XplaneAvgeek/Flight-Computer-V3/Flight_Computer_V2_Proto2/production/FlightComputerV1_Proto1_bom.csv

Designator | Footprint | Quantity | Value | LCSC Part #
C1, C2 | 0805 | 2 | 2.2uF
C10, C13, C18, C19, C22, C29, C31, C33, C34, C37, C38, C39, C41, C42, C46, C47, C48, C5, C50, C6, C7, C8 | 0402 | 22 | 100nF
C11, C14, C32, C49, C9 | 0603 | 5 | 1uF
C12, C15, C40 | 0805 | 3 | 4.7uF
C16, C17, C28, C44 | 1206 | 4 | 10uF
C20, C21, C43, C45 | 1206 | 4 | 22uF
C23 | 0603 | 1 | 100 nF 50V
C24 | 0805 | 1 | 2.2 uF
C25, C27 | 1206 | 2 | 10 uF 50V
C26 | 0603 | 1 | 4.7 nF
C3, C4 | 0402 | 2 | 27pF
C30, C36 | CP_Elec_4x5.3 | 2 | 10uF
C35 | 0402 | 1 | 220nF
D1 | D_SOD-323 | 1 | NSR0340HT1G
D10, D2, D7, D8, D9 | D_SOD-123F | 5 | DSS16U
D3 | D_SOD-123 | 1 | 1N4148W
D4 | 0603 | 1 | KT-0603B
D5, D6 | LED_WS2812B_PLCC4_5.0x5.0mm_P3.2mm | 2 | WS2812B
FB1 | 0603 | 1 | 600Ω@100MHz
IC1 | LGA-12_2x2mm_P0.5mm | 1 | IIS2MDCTR
J1 | microSD_HC_Hirose_DM3D-SF | 1 | Micro_SD_Card_Det_Hirose_DM3AT
J10, J11, J12, J13, J14, J23 | JST_SH_SM04B-SRSS-TB_1x04-1MP_P1.00mm_Horizontal | 6 | Conn_01x04_MountingPin
J15, J16, J17, J18, J19, J20, J21, J22 | PinHeader_1x03_P2.54mm_Vertical | 8 | Conn_01x03
J2 | PinHeader_1x04_P2.54mm_Vertical | 1 | Conn_01x04
J3 | USB_C_Receptacle_GCT_USB4110 | 1 | USB_C_Receptacle_USB2.0_16P
J4, J6, J7, J8 | PHOENIX_1935776 | 4 | Screw_Terminal_01x02
J9 | PHOENIX_1935776 | 1 | 1935776
L1 | L_Bourns_SRP5030T | 1 | 2.2uH
L2, L3 | 1008 | 2 | 3.3uH
Q1, Q10, Q11, Q2, Q3, Q4, Q7, Q8, Q9 | SOT-23 | 9 | AO3400A
Q5, Q6 | LFPAK56 | 2 | PSMN7R0-60YS
R1, R13, R17, R18, R2, R20, R22, R24, R26, R28, R29, R30, R31, R37, R39, R40, R6 | 0402 | 17 | 10K
R10, R11, R7, R8, R9 | 0402 | 5 | 47K
R12, R38 | 0402 | 2 | 33R
R14, R19 | 0402 | 2 | 22R
R15, R16 | 0402 | 2 | 5K1
R21, R23, R25, R27 | 0402 | 4 | 220R
R3 | 0402 | 1 | 56K2
R32 | 0402 | 1 | 51R
R33, R34, R41, R42, R43, R44, R45, R46, R47, R48, R49, R50, R51, R52, R53, R54, R55, R56, R57, R58 | 0402 | 20 | 4K7
R35, R36 | 0402 | 2 | 31K6
R4, R5 | 0603 | 2 | 10R
SW1, SW2 | SW_SPST_Omron_B3FS-101xP | 2 | SW_Omron_B3FS
U1 | TFBGA-100_8x8mm_Layout10x10_P0.8mm | 1 | STM32H743VIH6
U10, U7, U8, U9 | SOIC-8_3.9x4.9mm_P1.27mm | 4 | SI4116DY-T1-GE3
U11, U13 | SOT-563 | 2 | AP62150Z6
U12 | TSOP-5_1.65x3.05mm_P0.95mm | 1 | NCV4296-2CSN50T1G
U14 | SON127P600X800X80-9N | 1 | W25Q256JVEIQ_TR
U2 | SOT95P280X110-6N | 1 | TPS565208DDCR
U3 | DFN-6-1EP_2x2mm_P0.65mm_EP1x1.6mm | 1 | NCV68261
U4 | LGA-14_3x2.5mm_P0.5mm_LayoutBorder3x4y | 1 | LSM6DSO
U5 | SOT-23-6 | 1 | USBLC6-2SC6
U6 | ST_HLGA-10_2x2mm_P0.5mm_LayoutBorder3x2y | 1 | LPS22HB
Y1 | Crystal_SMD_5032-4Pin_5.0x3.2mm | 1 | ABM3B-8.000MHZ-B2-T
