XplaneAvgeek/Flight-Computer-V3/Flight_Computer_V2_Proto2/Flight_Computer_V2_Proto2.kicad_pcb

## KiCad design Flight_Computer_V2_Proto2/Flight_Computer_V2_Proto2.kicad_pcb (2026-09-26)

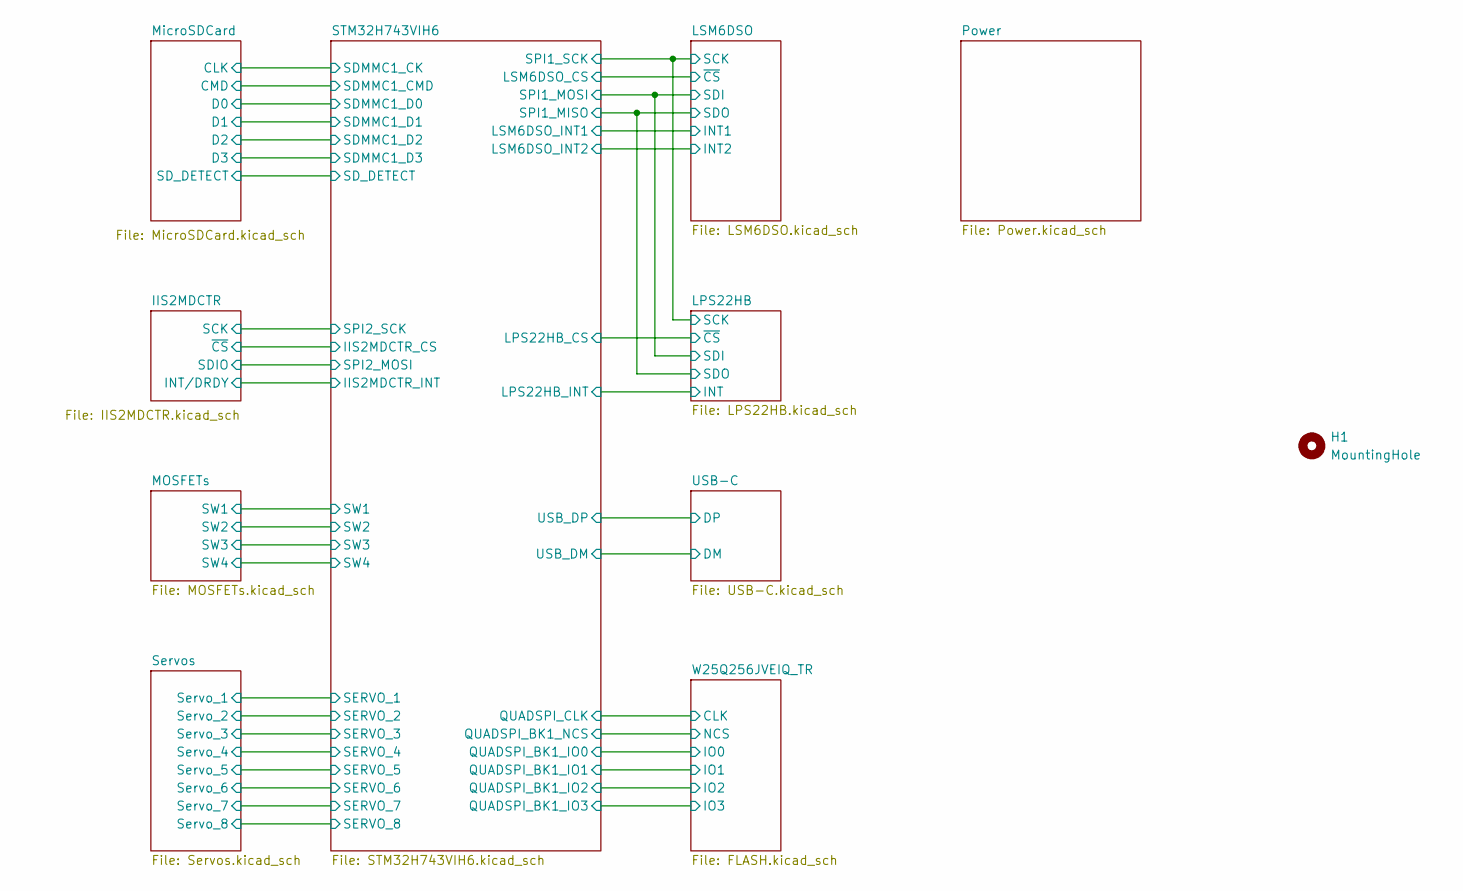
[picture p1: schematic Flight_Computer_V2_Proto2.kicad_sch]

Parts:
H1: MountingHole; logo15x15mmv3

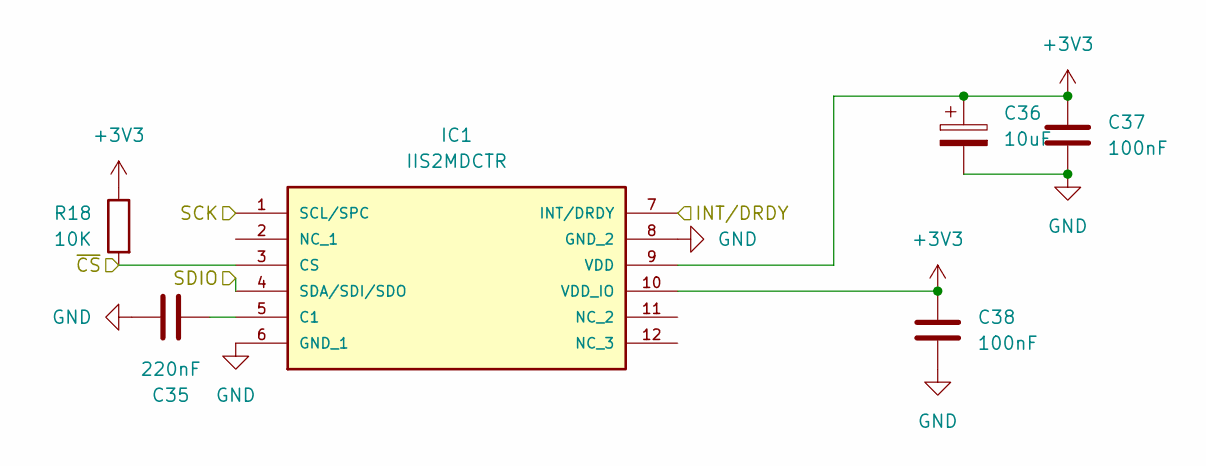
[picture p2: schematic IIS2MDCTR.kicad_sch]

Parts:
C35: 220nF; C_0402_1005Metric
C36: 10uF; CP_Elec_4x5.3
C37, C38: 100nF; C_0402_1005Metric
IC1: IIS2MDCTR; LGA-12_2x2mm_P0.5mm; MOUSER_PART_NUMBER 511-IIS2MDCTR
R18: 10K; R_0402_1005Metric

Connections:
+3V3: C36.1, C37.1, C38.1, IC1.9 (VDD), IC1.10 (VDD_IO), R18.1; also elsewhere on the board
/IIS2MDCTR/INT/DRDY: IC1.7 (INT/DRDY); also elsewhere on the board
/IIS2MDCTR/SCK: IC1.1 (SCL/SPC); also elsewhere on the board
/IIS2MDCTR/SDIO: IC1.4 (SDA/SDI/SDO); also elsewhere on the board
/IIS2MDCTR/~CS: IC1.3 (CS), R18.2; also elsewhere on the board
GND: C35.1, C36.2, C37.2, C38.2, IC1.6 (GND_1), IC1.8 (GND_2); also elsewhere on the board
unnamed: C35.2, IC1.5 (C1)

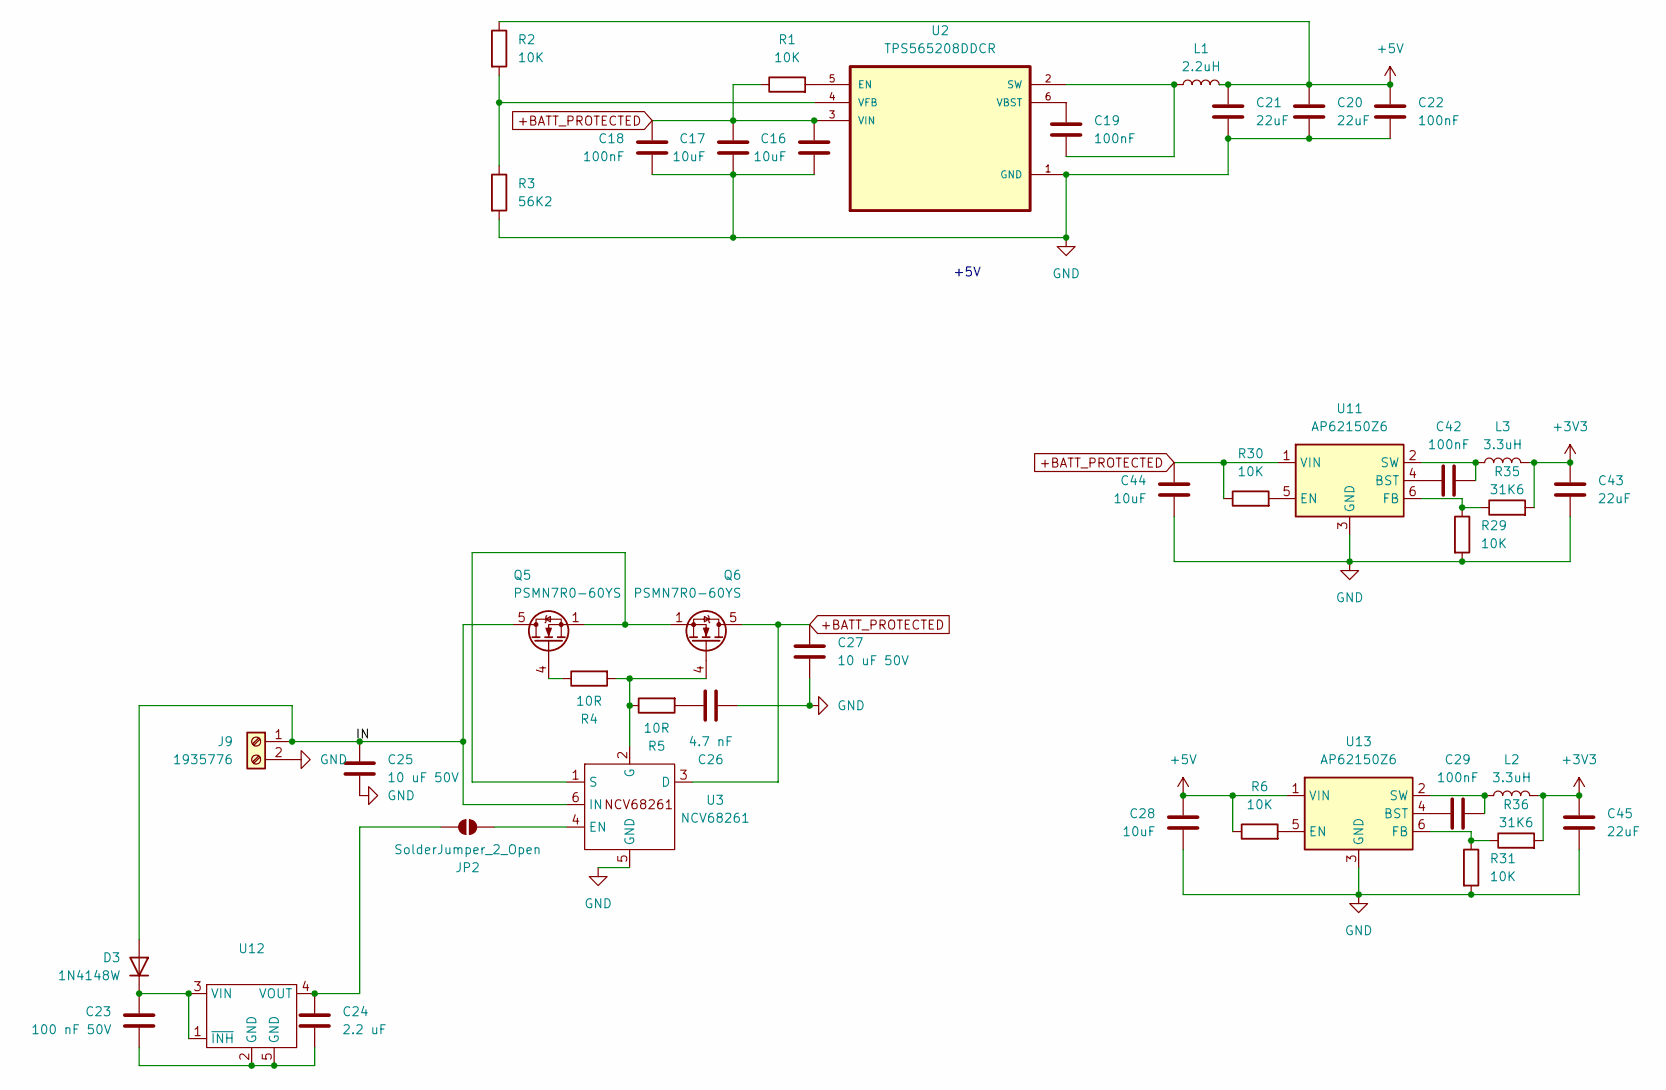
[picture p3: schematic Power.kicad_sch]

Parts:
C16, C17, C28, C44: 10uF; C_1206_3216Metric
C18, C19, C22, C29, C42: 100nF; C_0402_1005Metric
C20, C21, C43, C45: 22uF; C_1206_3216Metric
C23: 100 nF 50V; C_0603_1608Metric
C24: 2.2 uF; C_0805_2012Metric
C25, C27: 10 uF 50V; C_1206_3216Metric
C26: 4.7 nF; C_0603_1608Metric
D3: 1N4148W; D_SOD-123
J9: 1935776; PHOENIX_1935776
JP2: SolderJumper_2_Open; SolderJumper-2_P1.3mm_Open_TrianglePad1.0x1.5mm
L1: 2.2uH; L_Bourns_SRP5030T
L2, L3: 3.3uH; L_1008_2520Metric
Q5, Q6: PSMN7R0-60YS; LFPAK56
R1, R2, R6, R29, R30, R31: 10K; R_0402_1005Metric
R3: 56K2; R_0402_1005Metric
R4, R5: 10R; R_0603_1608Metric
R35, R36: 31K6; R_0402_1005Metric
U2: TPS565208DDCR; SOT95P280X110-6N
U3: NCV68261; DFN-6-1EP_2x2mm_P0.65mm_EP1x1.6mm
U11, U13: AP62150Z6; SOT-563
U12: NCV4296-2CSN50T1G; TSOP-5_1.65x3.05mm_P0.95mm

Connections:
+3V3: C43.1, C45.1, L2.2, L3.2, R35.2, R36.2; also elsewhere on the board
+5V: C20.1, C21.1, C22.1, C28.1, L1.2, R2.1, R6.1, U13.1 (VIN); also elsewhere on the board
+BATT_PROTECTED: C16.1, C17.1, C18.1, C27.1, C44.1, Q6.5 (D), R1.1, R30.1, U2.3 (VIN), U3.3 (D), U11.1 (VIN); also elsewhere on the board
/Power/IN: C25.1, D3.2 (A), J9.1, Q5.5 (D), U3.6 (IN)
GND: C16.2, C17.2, C18.2, C20.2, C21.2, C22.2, C25.2, C26.2, C27.2, C28.2, C43.2, C44.2, C45.2, J9.2, R3.2, R29.2, R31.2, U2.1 (GND), U3.5 (GND), U11.3 (GND), U13.3 (GND); also elsewhere on the board
unnamed: C23.2, C24.2, U12.2 (GND), U12.5 (GND)
unnamed: C26.1, R5.2
unnamed: C23.1, D3.1 (K), U12.1 (~INH), U12.3 (VIN)
unnamed: JP2.1 (A), U3.4 (EN)
unnamed: C24.1, JP2.2 (B), U12.4 (VOUT)
unnamed: Q5.4 (G), R4.1
unnamed: Q6.4 (G), R4.2, R5.1, U3.2 (G)
unnamed: R1.2, U2.5 (EN)
unnamed: C19.2, L1.1, U2.2 (SW)
unnamed: C19.1, U2.6 (VBST)
unnamed: R2.2, R3.1, U2.4 (VFB)
unnamed: Q5.1 (S), Q5.2 (S), Q5.3 (S), Q6.1 (S), Q6.2 (S), Q6.3 (S), U3.1 (S)
unnamed: C42.1, U11.4 (BST)
unnamed: R30.2, U11.5 (EN)
unnamed: R29.1, R35.1, U11.6 (FB)
unnamed: C42.2, L3.1, U11.2 (SW)
unnamed: C29.1, U13.4 (BST)
unnamed: R6.2, U13.5 (EN)
unnamed: R31.1, R36.1, U13.6 (FB)
unnamed: C29.2, L2.1, U13.2 (SW)

Notes on the sheet:
+5V

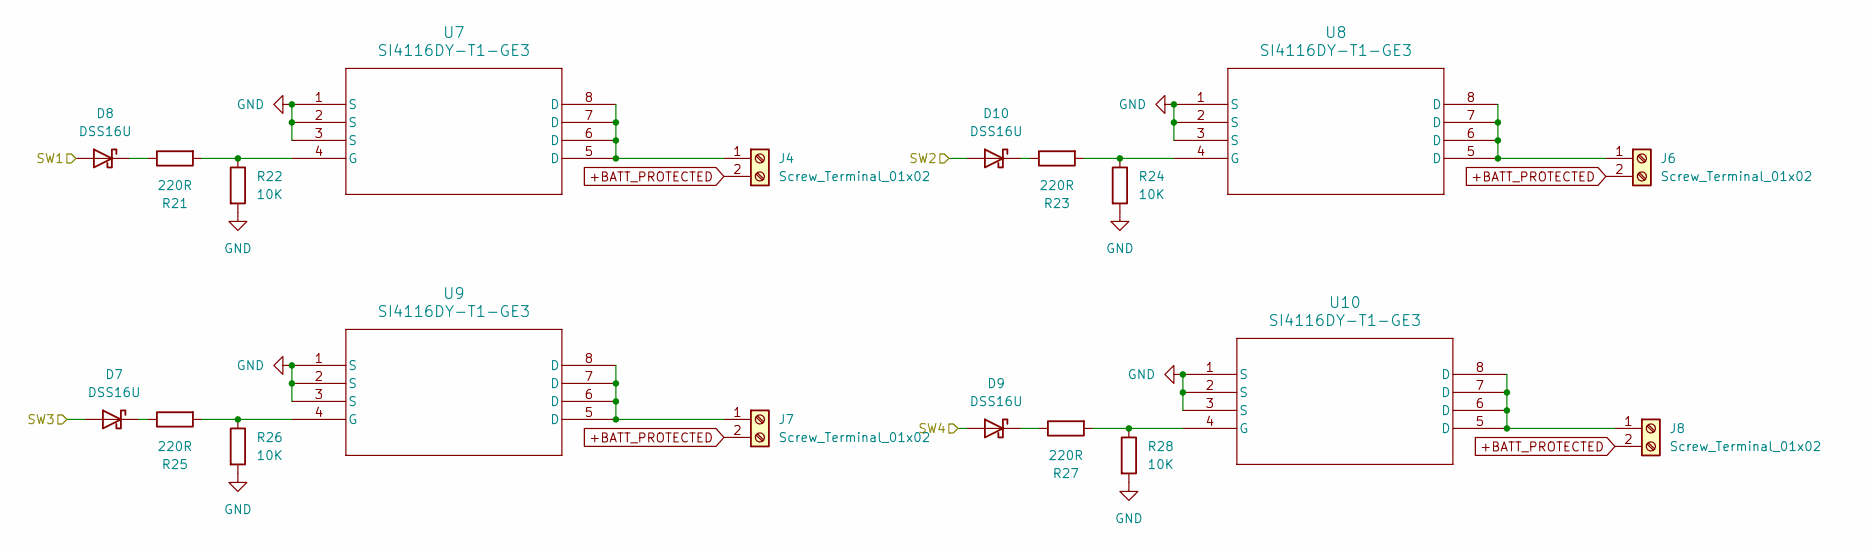
[picture p4: schematic MOSFETs.kicad_sch]

Parts:
D7, D8, D9, D10: DSS16U; D_SOD-123F
J4, J6, J7, J8: Screw_Terminal_01x02; PHOENIX_1935776
R21, R23, R25, R27: 220R; R_0402_1005Metric
R22, R24, R26, R28: 10K; R_0402_1005Metric
U7, U8, U9, U10: SI4116DY-T1-GE3; SOIC-8_3.9x4.9mm_P1.27mm

Connections:
+BATT_PROTECTED: J4.2, J6.2, J7.2, J8.2; also elsewhere on the board
/MOSFETs/SW1: D8.2 (A); also elsewhere on the board
/MOSFETs/SW2: D10.2 (A); also elsewhere on the board
/MOSFETs/SW3: D7.2 (A); also elsewhere on the board
/MOSFETs/SW4: D9.2 (A); also elsewhere on the board
GND: R22.2, R24.2, R26.2, R28.2, U7.1 (S), U7.2 (S), U7.3 (S), U8.1 (S), U8.2 (S), U8.3 (S), U9.1 (S), U9.2 (S), U9.3 (S), U10.1 (S), U10.2 (S), U10.3 (S); also elsewhere on the board
unnamed: D7.1 (K), R25.1
unnamed: D8.1 (K), R21.1
unnamed: D9.1 (K), R27.1
unnamed: D10.1 (K), R23.1
unnamed: J4.1, U7.5 (D), U7.6 (D), U7.7 (D), U7.8 (D)
unnamed: J6.1, U8.5 (D), U8.6 (D), U8.7 (D), U8.8 (D)
unnamed: J7.1, U9.5 (D), U9.6 (D), U9.7 (D), U9.8 (D)
unnamed: J8.1, U10.5 (D), U10.6 (D), U10.7 (D), U10.8 (D)
unnamed: R21.2, R22.1, U7.4 (G)
unnamed: R23.2, R24.1, U8.4 (G)
unnamed: R25.2, R26.1, U9.4 (G)
unnamed: R27.2, R28.1, U10.4 (G)

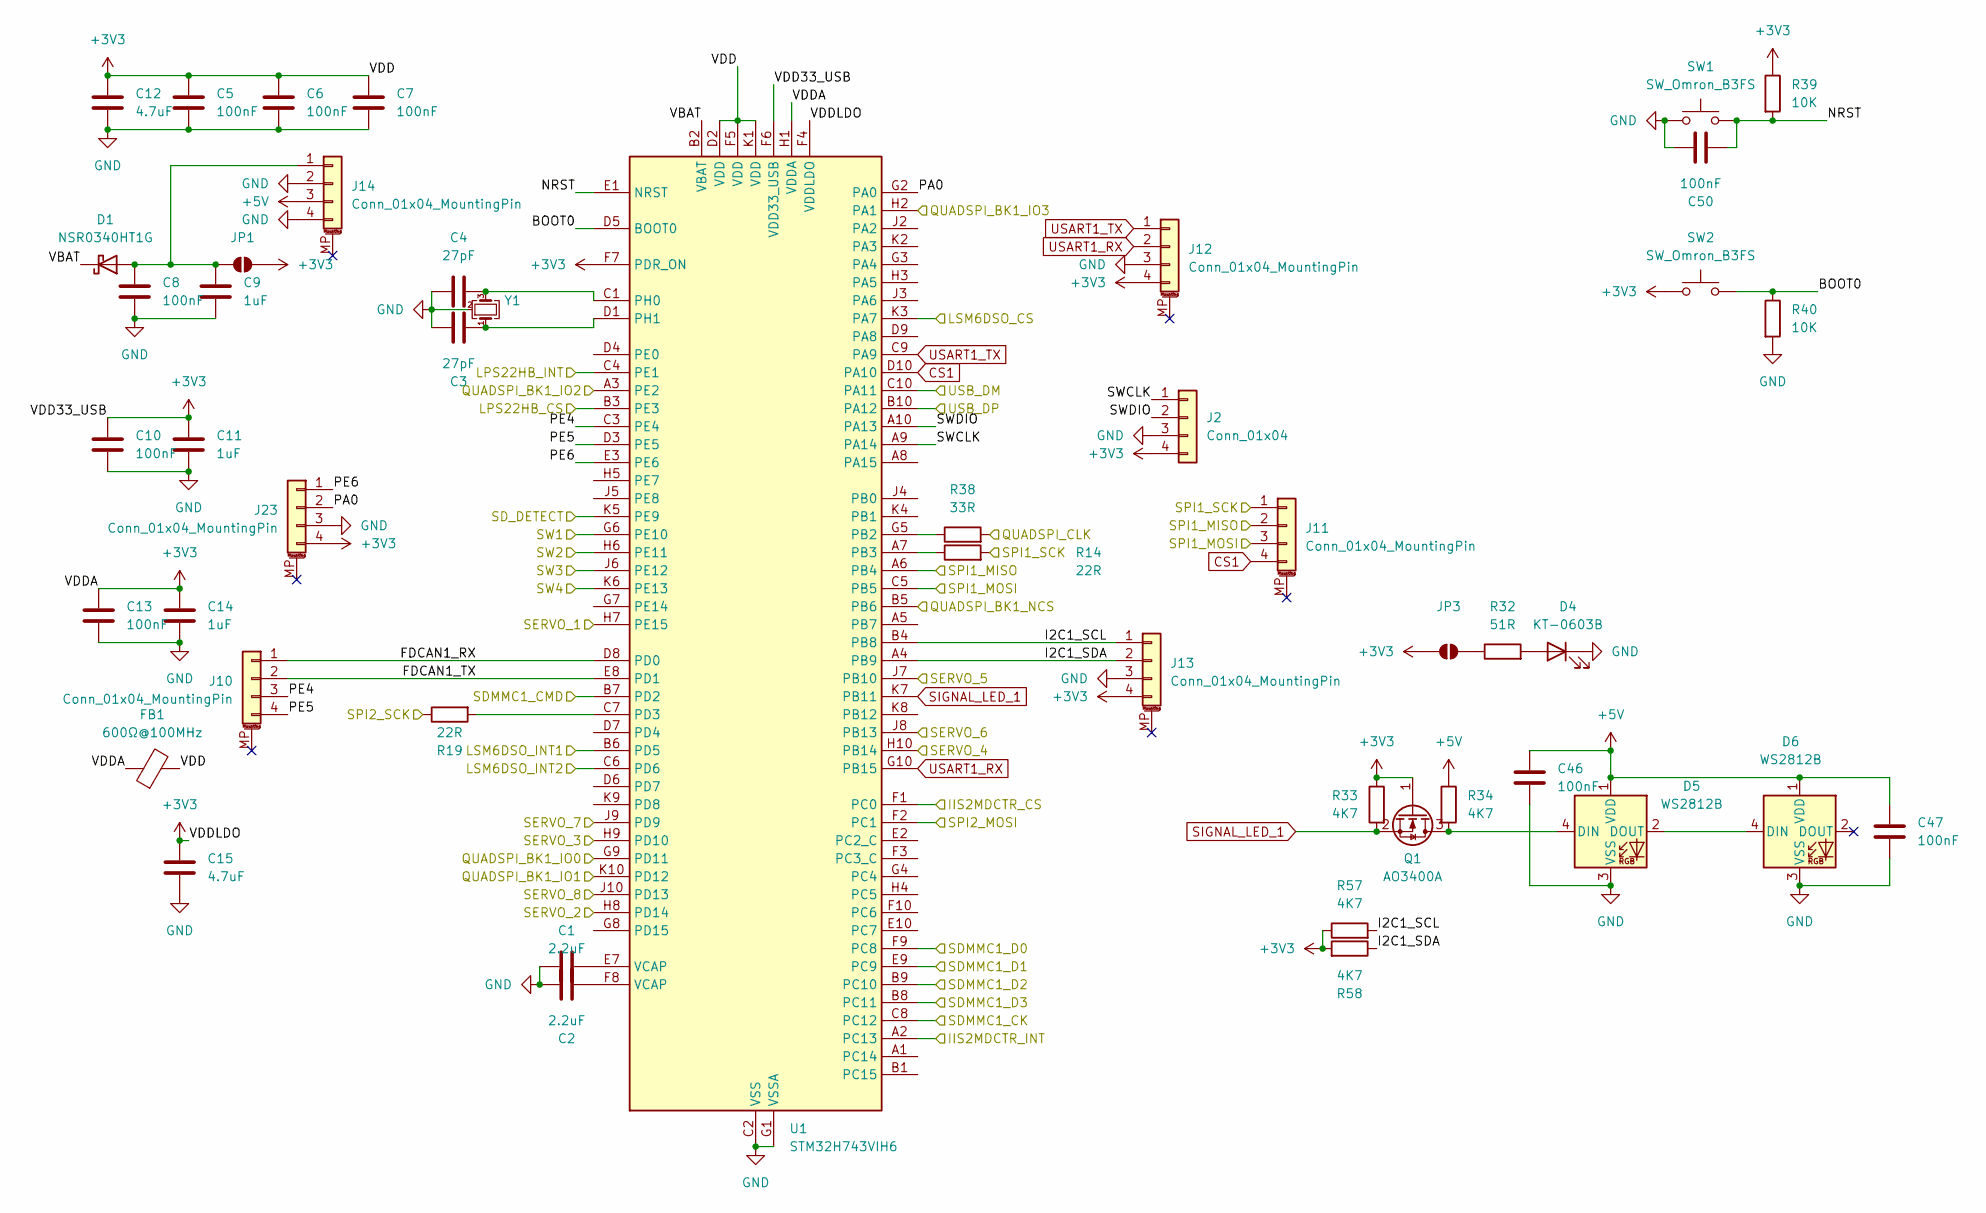
[picture p5: schematic STM32H743VIH6.kicad_sch]

Parts:
C1, C2: 2.2uF; C_0805_2012Metric
C3, C4: 27pF; C_0402_1005Metric
C5, C6, C7, C8, C10, C13, C46, C47, C50: 100nF; C_0402_1005Metric
C9, C11, C14: 1uF; C_0603_1608Metric
C12, C15: 4.7uF; C_0805_2012Metric
D1: NSR0340HT1G; D_SOD-323
D4: KT-0603B; LED_0603_1608Metric
D5, D6: WS2812B; LED_WS2812B_PLCC4_5.0x5.0mm_P3.2mm
FB1: 600Ω@100MHz; L_0603_1608Metric
J2: Conn_01x04; PinHeader_1x04_P2.54mm_Vertical
J10, J11, J12, J13, J14, J23: Conn_01x04_MountingPin; JST_SH_SM04B-SRSS-TB_1x04-1MP_P1.00mm_Horizontal
JP1, JP3: SolderJumper_2_Open; SolderJumper-2_P1.3mm_Open_TrianglePad1.0x1.5mm
Q1: AO3400A; SOT-23
R14, R19: 22R; R_0402_1005Metric
R32: 51R; R_0402_1005Metric
R33, R34, R57, R58: 4K7; R_0402_1005Metric
R38: 33R; R_0402_1005Metric
R39, R40: 10K; R_0402_1005Metric
SW1, SW2: SW_Omron_B3FS; SW_SPST_Omron_B3FS-101xP
U1: STM32H743VIH6; TFBGA-100_8x8mm_Layout10x10_P0.8mm
Y1: ABM3B-8.000MHZ-B2-T; Crystal_SMD_5032-4Pin_5.0x3.2mm

Connections:
+3V3: C5.1, C6.1, C7.1, C10.1, C11.1, C12.2, C13.1, C14.1, C15.2, FB1.1, FB1.2, J2.4, J12.4, J13.4, J23.4, JP1.1 (A), JP3.1 (A), Q1.1 (G), R33.1, R39.1, R57.1, R58.2, SW2.1, U1.D2 (VDD), U1.F4 (VDDLDO), U1.F5 (VDD), U1.F6 (VDD33_USB), U1.F7 (PDR_ON), U1.H1 (VDDA), U1.K1 (VDD); also elsewhere on the board
+5V: C46.1, C47.1, D5.1 (VDD), D6.1 (VDD), J14.3, R34.1; also elsewhere on the board
/IIS2MDCTR/INT/DRDY: U1.A2 (PC13); also elsewhere on the board
/IIS2MDCTR/SCK: R19.1; also elsewhere on the board
/IIS2MDCTR/SDIO: U1.F2 (PC1); also elsewhere on the board
/IIS2MDCTR/~CS: U1.F1 (PC0); also elsewhere on the board
/LPS22HB/INT: U1.C4 (PE1); also elsewhere on the board
/LPS22HB/SCK: J11.1, R14.2; also elsewhere on the board
/LPS22HB/SDI: J11.3, U1.C5 (PB5); also elsewhere on the board
/LPS22HB/SDO: J11.2, U1.A6 (PB4); also elsewhere on the board
/LPS22HB/~CS: U1.B3 (PE3); also elsewhere on the board
/LSM6DSO/INT1: U1.B6 (PD5); also elsewhere on the board
/LSM6DSO/INT2: U1.C6 (PD6); also elsewhere on the board
/LSM6DSO/~CS: U1.K3 (PA7); also elsewhere on the board
/MOSFETs/SW1: U1.G6 (PE10); also elsewhere on the board
/MOSFETs/SW2: U1.H6 (PE11); also elsewhere on the board
/MOSFETs/SW3: U1.J6 (PE12); also elsewhere on the board
/MOSFETs/SW4: U1.K6 (PE13); also elsewhere on the board
/MicroSDCard/CLK: U1.C8 (PC12); also elsewhere on the board
/MicroSDCard/CMD: U1.B7 (PD2); also elsewhere on the board
/MicroSDCard/D0: U1.F9 (PC8); also elsewhere on the board
/MicroSDCard/D1: U1.E9 (PC9); also elsewhere on the board
/MicroSDCard/D2: U1.B9 (PC10); also elsewhere on the board
/MicroSDCard/D3: U1.B8 (PC11); also elsewhere on the board
/MicroSDCard/SD_DETECT: U1.K5 (PE9); also elsewhere on the board
/STM32H743VIH6/BOOT0: R40.1, SW2.2, U1.D5 (BOOT0)
/STM32H743VIH6/FDCAN1_RX: J10.1, U1.D8 (PD0)
/STM32H743VIH6/FDCAN1_TX: J10.2, U1.E8 (PD1)
/STM32H743VIH6/I2C1_SCL: J13.1, R57.2, U1.B4 (PB8)
/STM32H743VIH6/I2C1_SDA: J13.2, R58.1, U1.A4 (PB9)
/STM32H743VIH6/NRST: C50.2, R39.2, SW1.2, U1.E1 (NRST)
/STM32H743VIH6/PA0: J23.2, U1.G2 (PA0)
/STM32H743VIH6/PE4: J10.3, U1.C3 (PE4)
/STM32H743VIH6/PE5: J10.4, U1.D3 (PE5)
/STM32H743VIH6/PE6: J23.1, U1.E3 (PE6)
/STM32H743VIH6/QUADSPI_BK1_IO0: U1.G9 (PD11); also elsewhere on the board
/STM32H743VIH6/QUADSPI_BK1_IO1: U1.K10 (PD12); also elsewhere on the board
/STM32H743VIH6/QUADSPI_BK1_IO2: U1.A3 (PE2); also elsewhere on the board
/STM32H743VIH6/QUADSPI_BK1_IO3: U1.H2 (PA1); also elsewhere on the board
/STM32H743VIH6/QUADSPI_BK1_NCS: U1.B5 (PB6); also elsewhere on the board
/STM32H743VIH6/QUADSPI_CLK: R38.2; also elsewhere on the board
/STM32H743VIH6/SERVO_1: U1.H7 (PE15); also elsewhere on the board
/STM32H743VIH6/SERVO_2: U1.H8 (PD14); also elsewhere on the board
/STM32H743VIH6/SERVO_3: U1.H9 (PD10); also elsewhere on the board
/STM32H743VIH6/SERVO_4: U1.H10 (PB14); also elsewhere on the board
/STM32H743VIH6/SERVO_5: U1.J7 (PB10); also elsewhere on the board
/STM32H743VIH6/SERVO_6: U1.J8 (PB13); also elsewhere on the board
/STM32H743VIH6/SERVO_7: U1.J9 (PD9); also elsewhere on the board
/STM32H743VIH6/SERVO_8: U1.J10 (PD13); also elsewhere on the board
/STM32H743VIH6/SWCLK: J2.1, U1.A9 (PA14)
/STM32H743VIH6/SWDIO: J2.2, U1.A10 (PA13)
/STM32H743VIH6/USB_DM: U1.C10 (PA11); also elsewhere on the board
/STM32H743VIH6/USB_DP: U1.B10 (PA12); also elsewhere on the board
/STM32H743VIH6/VBAT: D1.1 (K), U1.B2 (VBAT)
CS1: J11.4, U1.D10 (PA10)
GND: C1.1, C2.1, C3.1, C4.1, C5.2, C6.2, C7.2, C8.2, C9.2, C10.2, C11.2, C12.1, C13.2, C14.2, C15.1, C46.2, C47.2, C50.1, D4.1 (K), D5.3 (VSS), D6.3 (VSS), J2.3, J12.3, J13.3, J14.2, J14.4, J23.3, R40.2, SW1.1, U1.C2 (VSS), U1.E4 (VSS), U1.E5 (VSS), U1.E6 (VSS), U1.G1 (VSSA), U1.J1 (VSS), Y1.2 (G), Y1.4 (G); also elsewhere on the board
unnamed: C1.2, U1.E7 (VCAP)
unnamed: C2.2, U1.F8 (VCAP)
unnamed: C8.1, C9.1, D1.2 (A), J14.1, JP1.2 (B)
unnamed: D4.2 (A), R32.2
unnamed: D5.4 (DIN), Q1.3 (D), R34.2
unnamed: D5.2 (DOUT), D6.4 (DIN)
unnamed: JP3.2 (B), R32.1
unnamed: R38.1, U1.G5 (PB2)
unnamed: R14.1, U1.A7 (PB3)
unnamed: R19.2, U1.C7 (PD3)
unnamed: C4.2, U1.C1 (PH0), Y1.3
unnamed: C3.2, U1.D1 (PH1), Y1.1
SIGNAL_LED_1: Q1.2 (S), R33.2, U1.K7 (PB11)
USART1_RX: J12.2, U1.G10 (PB15)
USART1_TX: J12.1, U1.C9 (PA9)

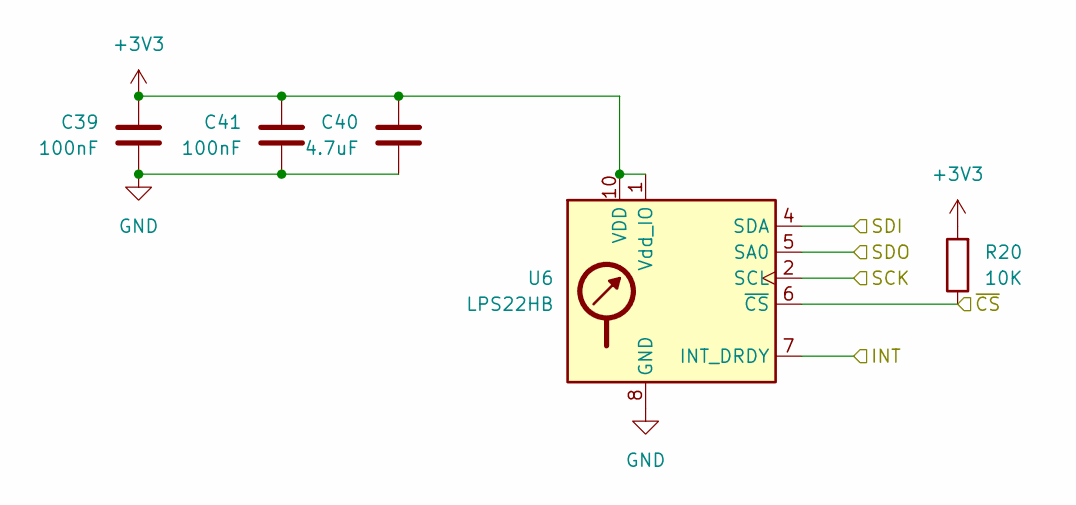
[picture p6: schematic LPS22HB.kicad_sch]

Parts:
C39, C41: 100nF; C_0402_1005Metric
C40: 4.7uF; C_0805_2012Metric
R20: 10K; R_0402_1005Metric
U6: LPS22HB; ST_HLGA-10_2x2mm_P0.5mm_LayoutBorder3x2y

Connections:
+3V3: C39.1, C40.1, C41.1, R20.2, U6.1 (Vdd_IO), U6.10 (VDD); also elsewhere on the board
/LPS22HB/INT: U6.7 (INT_DRDY); also elsewhere on the board
/LPS22HB/SCK: U6.2 (SCL); also elsewhere on the board
/LPS22HB/SDI: U6.4 (SDA); also elsewhere on the board
/LPS22HB/SDO: U6.5 (SA0); also elsewhere on the board
/LPS22HB/~CS: R20.1, U6.6 (~CS); also elsewhere on the board
GND: C39.2, C40.2, C41.2, U6.3 (GND), U6.8 (GND), U6.9 (GND); also elsewhere on the board

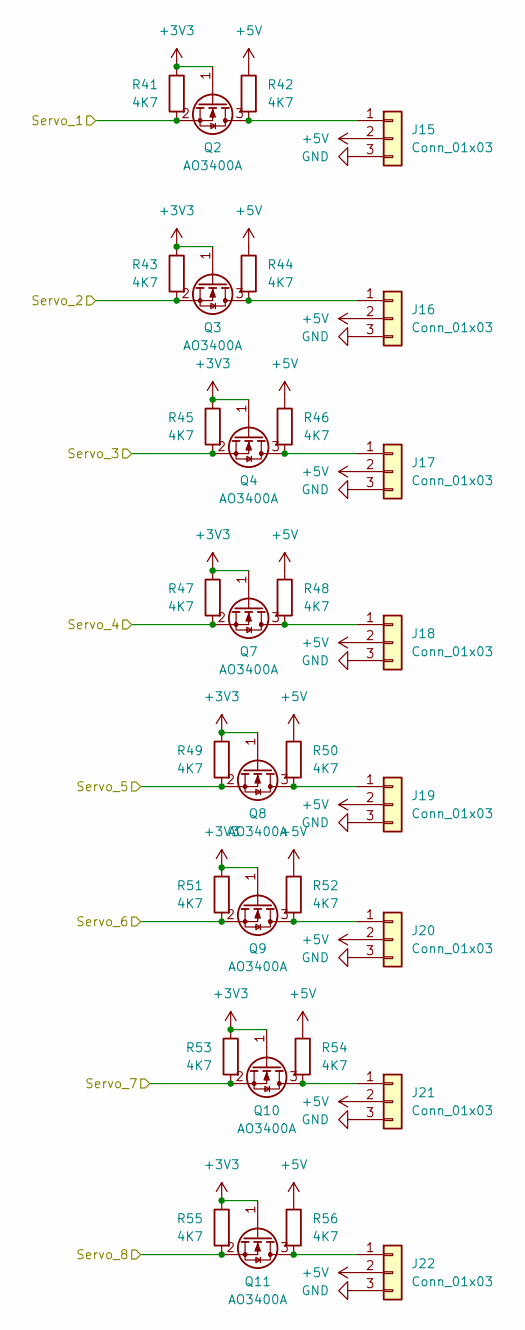
[picture p7: schematic Servos.kicad_sch]

Parts:
J15, J16, J17, J18, J19, J20, J21, J22: Conn_01x03; PinHeader_1x03_P2.54mm_Vertical
Q2, Q3, Q4, Q7, Q8, Q9, Q10, Q11: AO3400A; SOT-23
R41, R42, R43, R44, R45, R46, R47, R48, R49, R50, R51, R52, R53, R54, R55, R56: 4K7; R_0402_1005Metric

Connections:
+3V3: Q2.1 (G), Q3.1 (G), Q4.1 (G), Q7.1 (G), Q8.1 (G), Q9.1 (G), Q10.1 (G), Q11.1 (G), R41.1, R43.1, R45.1, R47.1, R49.1, R51.1, R53.1, R55.1; also elsewhere on the board
+5V: J15.2, J16.2, J17.2, J18.2, J19.2, J20.2, J21.2, J22.2, R42.1, R44.1, R46.1, R48.1, R50.1, R52.1, R54.1, R56.1; also elsewhere on the board
/STM32H743VIH6/SERVO_1: Q2.2 (S), R41.2; also elsewhere on the board
/STM32H743VIH6/SERVO_2: Q3.2 (S), R43.2; also elsewhere on the board
/STM32H743VIH6/SERVO_3: Q4.2 (S), R45.2; also elsewhere on the board
/STM32H743VIH6/SERVO_4: Q7.2 (S), R47.2; also elsewhere on the board
/STM32H743VIH6/SERVO_5: Q8.2 (S), R49.2; also elsewhere on the board
/STM32H743VIH6/SERVO_6: Q9.2 (S), R51.2; also elsewhere on the board
/STM32H743VIH6/SERVO_7: Q10.2 (S), R53.2; also elsewhere on the board
/STM32H743VIH6/SERVO_8: Q11.2 (S), R55.2; also elsewhere on the board
GND: J15.3, J16.3, J17.3, J18.3, J19.3, J20.3, J21.3, J22.3; also elsewhere on the board
unnamed: J15.1, Q2.3 (D), R42.2
unnamed: J16.1, Q3.3 (D), R44.2
unnamed: J17.1, Q4.3 (D), R46.2
unnamed: J18.1, Q7.3 (D), R48.2
unnamed: J19.1, Q8.3 (D), R50.2
unnamed: J20.1, Q9.3 (D), R52.2
unnamed: J21.1, Q10.3 (D), R54.2
unnamed: J22.1, Q11.3 (D), R56.2

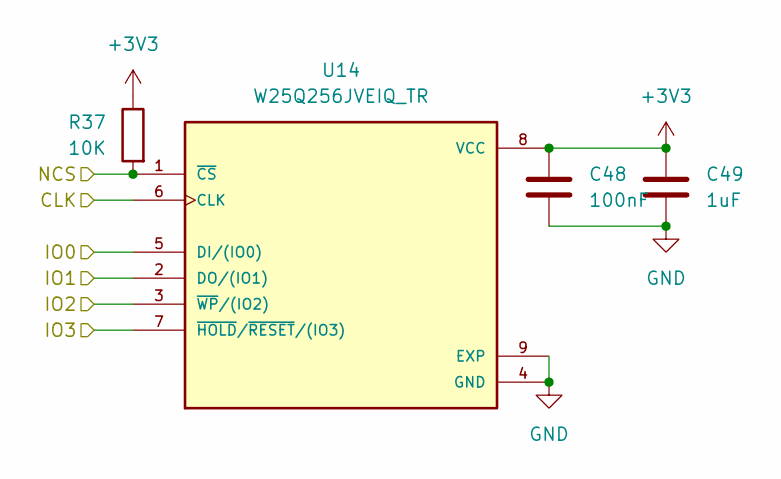
[picture p8: schematic FLASH.kicad_sch]

Parts:
C48: 100nF; C_0402_1005Metric
C49: 1uF; C_0603_1608Metric
R37: 10K; R_0402_1005Metric
U14: W25Q256JVEIQ_TR; SON127P600X800X80-9N; PARTREV G

Connections:
+3V3: C48.1, C49.1, R37.1, U14.8 (VCC); also elsewhere on the board
/STM32H743VIH6/QUADSPI_BK1_IO0: U14.5 (DI/(IO0)); also elsewhere on the board
/STM32H743VIH6/QUADSPI_BK1_IO1: U14.2 (DO/(IO1)); also elsewhere on the board
/STM32H743VIH6/QUADSPI_BK1_IO2: U14.3 (~WP/(IO2)); also elsewhere on the board
/STM32H743VIH6/QUADSPI_BK1_IO3: U14.7 (~HOLD/~RESET/(IO3)); also elsewhere on the board
/STM32H743VIH6/QUADSPI_BK1_NCS: R37.2, U14.1 (~CS); also elsewhere on the board
/STM32H743VIH6/QUADSPI_CLK: U14.6 (CLK); also elsewhere on the board
GND: C48.2, C49.2, U14.4 (GND), U14.9 (EXP); also elsewhere on the board

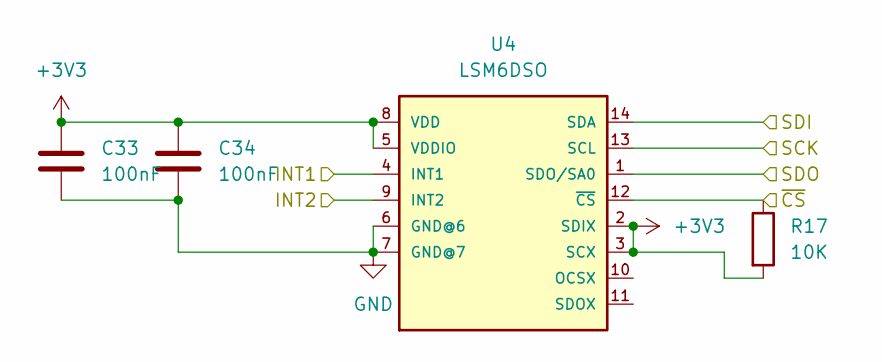
[picture p9: schematic LSM6DSO.kicad_sch]

Parts:
C33, C34: 100nF; C_0402_1005Metric
R17: 10K; R_0402_1005Metric
U4: LSM6DSO; LGA-14_3x2.5mm_P0.5mm_LayoutBorder3x4y

Connections:
+3V3: C33.1, C34.1, R17.2, U4.2 (SDIX), U4.3 (SCX), U4.5 (VDDIO), U4.8 (VDD); also elsewhere on the board
/LPS22HB/SCK: U4.13 (SCL); also elsewhere on the board
/LPS22HB/SDI: U4.14 (SDA); also elsewhere on the board
/LPS22HB/SDO: U4.1 (SDO/SA0); also elsewhere on the board
/LSM6DSO/INT1: U4.4 (INT1); also elsewhere on the board
/LSM6DSO/INT2: U4.9 (INT2); also elsewhere on the board
/LSM6DSO/~CS: R17.1, U4.12 (~CS); also elsewhere on the board
GND: C33.2, C34.2, U4.6 (GND@6), U4.7 (GND@7); also elsewhere on the board

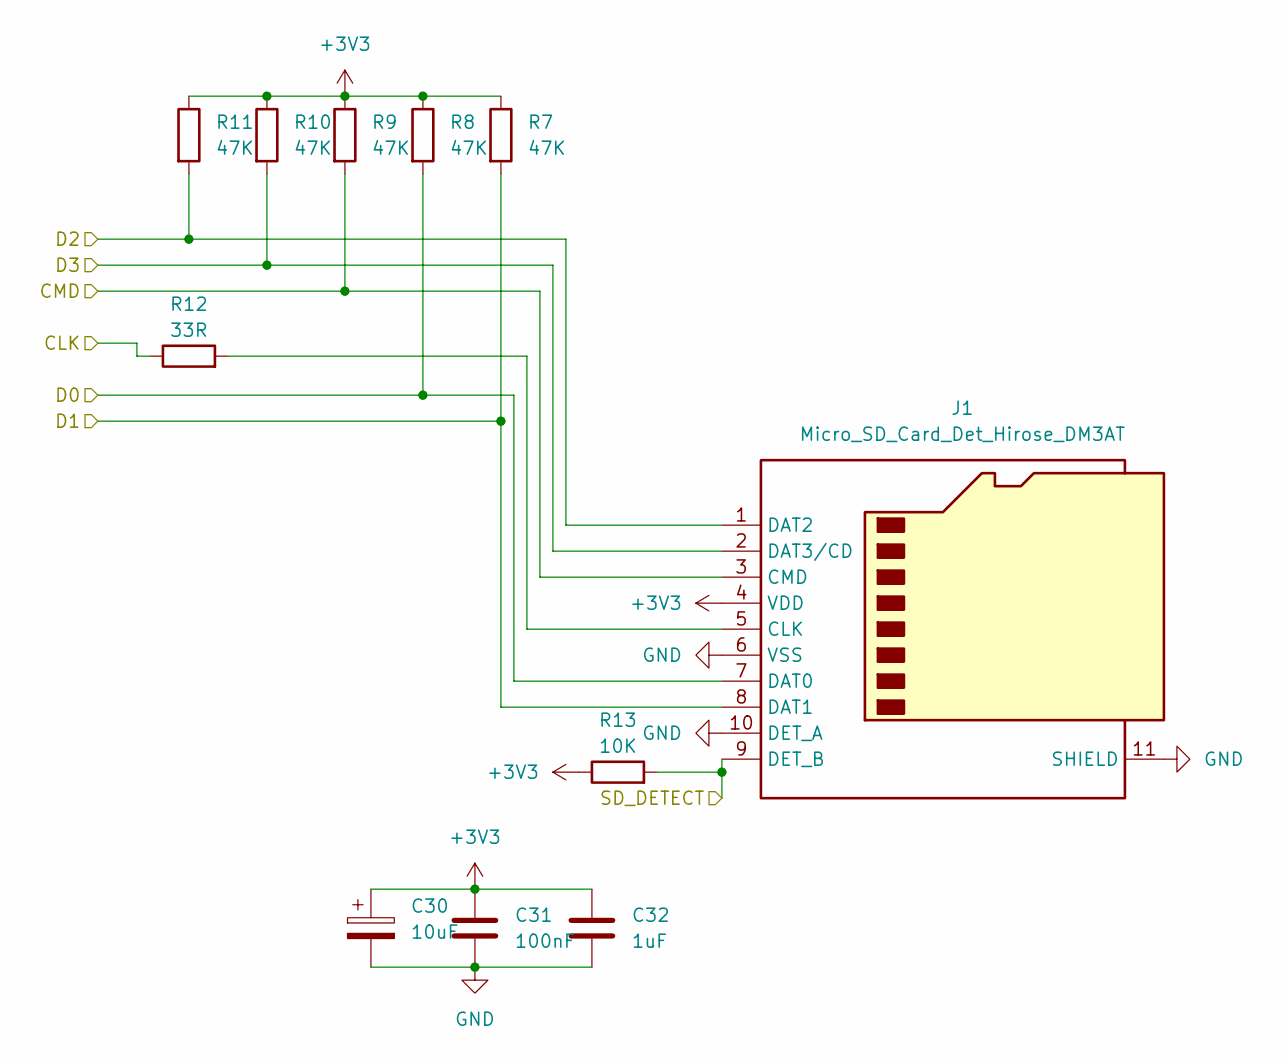
[picture p10: schematic MicroSDCard.kicad_sch]

Parts:
C30: 10uF; CP_Elec_4x5.3
C31: 100nF; C_0402_1005Metric
C32: 1uF; C_0603_1608Metric
J1: Micro_SD_Card_Det_Hirose_DM3AT; microSD_HC_Hirose_DM3D-SF
R7, R8, R9, R10, R11: 47K; R_0402_1005Metric
R12: 33R; R_0402_1005Metric
R13: 10K; R_0402_1005Metric

Connections:
+3V3: C30.1, C31.1, C32.1, J1.4 (VDD), R7.1, R8.1, R9.1, R10.1, R11.1, R13.1; also elsewhere on the board
/MicroSDCard/CLK: R12.1; also elsewhere on the board
/MicroSDCard/CMD: J1.3 (CMD), R9.2; also elsewhere on the board
/MicroSDCard/D0: J1.7 (DAT0), R8.2; also elsewhere on the board
/MicroSDCard/D1: J1.8 (DAT1), R7.2; also elsewhere on the board
/MicroSDCard/D2: J1.1 (DAT2), R11.2; also elsewhere on the board
/MicroSDCard/D3: J1.2 (DAT3/CD), R10.2; also elsewhere on the board
/MicroSDCard/SD_DETECT: J1.9 (DET_B), R13.2; also elsewhere on the board
GND: C30.2, C31.2, C32.2, J1.6 (VSS), J1.10 (DET_A), J1.11 (SHIELD); also elsewhere on the board
unnamed: J1.5 (CLK), R12.2

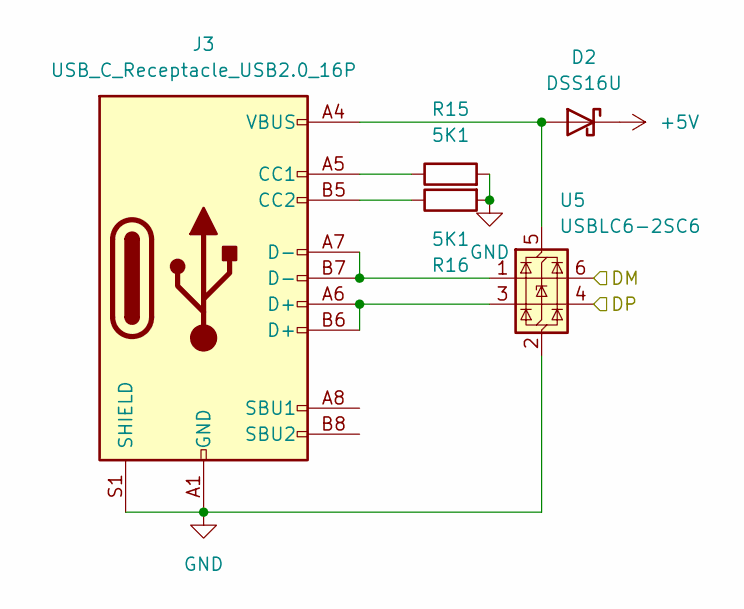
[picture p11: schematic USB-C.kicad_sch]

Parts:
D2: DSS16U; D_SOD-123F
J3: USB_C_Receptacle_USB2.0_16P; USB_C_Receptacle_GCT_USB4110
R15, R16: 5K1; R_0402_1005Metric
U5: USBLC6-2SC6; SOT-23-6

Connections:
+5V: D2.1 (K); also elsewhere on the board
/STM32H743VIH6/USB_DM: U5.6 (I/O1); also elsewhere on the board
/STM32H743VIH6/USB_DP: U5.4 (I/O2); also elsewhere on the board
GND: J3.A1 (GND), J3.A12 (GND), J3.B1 (GND), J3.B12 (GND), J3.S1 (SHIELD), R15.2, R16.2, U5.2 (GND); also elsewhere on the board
unnamed: D2.2 (A), J3.A4 (VBUS), J3.A9 (VBUS), J3.B4 (VBUS), J3.B9 (VBUS), U5.5 (VBUS)
unnamed: J3.A5 (CC1), R15.1
unnamed: J3.B5 (CC2), R16.1
unnamed: J3.A6 (D+), J3.B6 (D+), U5.3 (I/O2)
unnamed: J3.A7 (D-), J3.B7 (D-), U5.1 (I/O1)

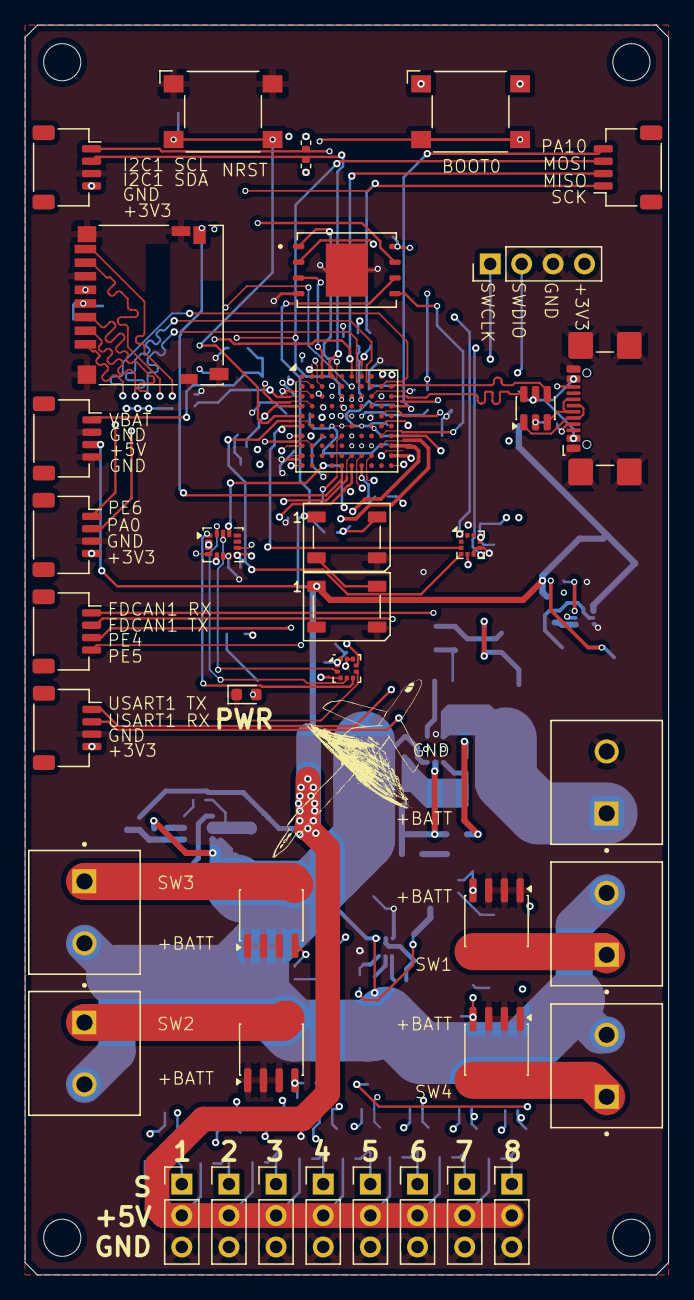
[picture p12: board Flight_Computer_V2_Proto2.kicad_pcb from above]

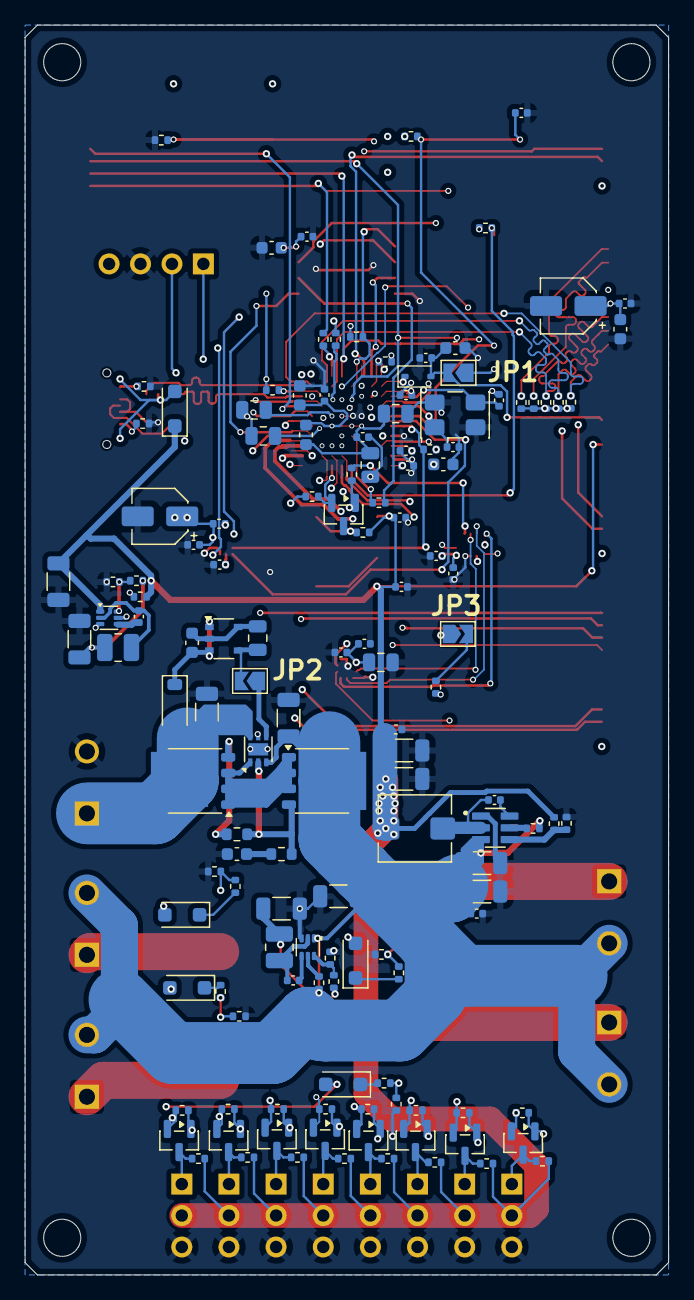
[picture p13: board Flight_Computer_V2_Proto2.kicad_pcb from below]

Board: 6 copper layers, 52.0 x 101.0 mm, 177 parts (137 on the bottom side), 120 nets.
